Dinamiet/LifeCounter_PCB/LifeCounter.kicad_pcb

## KiCad design LifeCounter.kicad_pcb (2025-07-05)

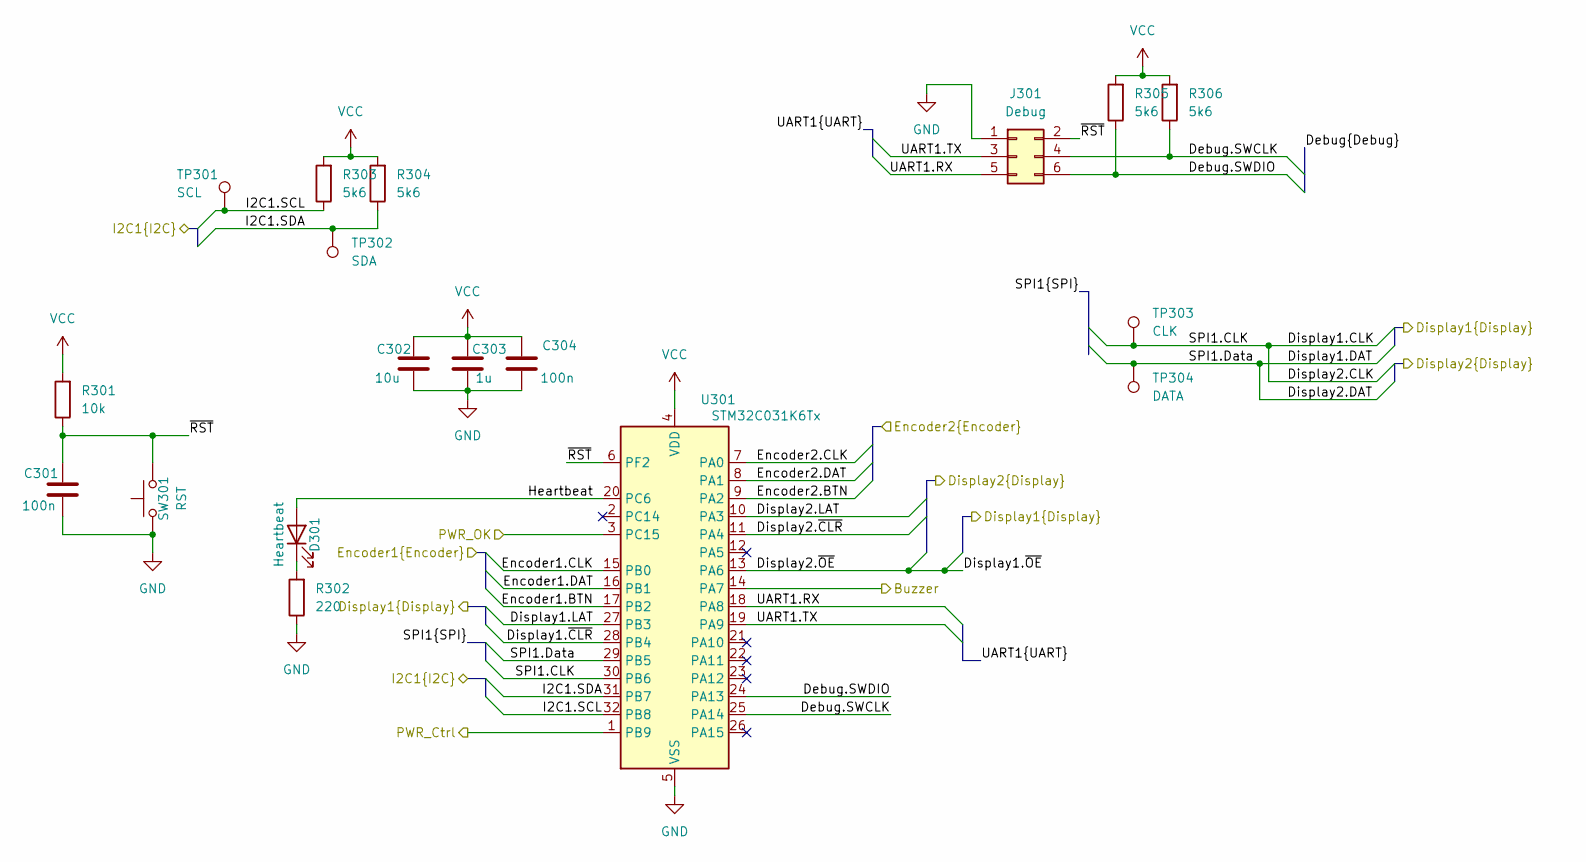
[picture p1: schematic controller.kicad_sch]

Parts:
C301, C304: 100n; C_1206_3216Metric_Pad1.33x1.80mm_HandSolder
C302: 10u; C_1206_3216Metric_Pad1.33x1.80mm_HandSolder
C303: 1u; C_0805_2012Metric_Pad1.18x1.45mm_HandSolder; LCSC C7393927
D301: Heartbeat; LED_1206_3216Metric_Pad1.42x1.75mm_HandSolder
J301: Debug; PinHeader_2x03_P2.54mm_Vertical_SMD
R301: 10k; R_1206_3216Metric_Pad1.30x1.75mm_HandSolder
R302: 220; R_1206_3216Metric_Pad1.30x1.75mm_HandSolder
R303, R304, R305, R306: 5k6; R_1206_3216Metric_Pad1.30x1.75mm_HandSolder
SW301: RST; SW_PUSH_6mm
TP301: SCL; TestPoint_Pad_D1.0mm
TP302: SDA; TestPoint_Pad_D1.0mm
TP303: CLK; TestPoint_Pad_D1.0mm
TP304: DATA; TestPoint_Pad_D1.0mm
U301: STM32C031K6Tx; LQFP-32_7x7mm_P0.8mm; LCSC C5456169

Connections:
/Buzzer/Buzz: U301.14 (PA7); also elsewhere on the board
/Controller/Debug.SWCLK: J301.4, R306.1, U301.25 (PA14)
/Controller/Debug.SWDIO: J301.6, R305.1, U301.24 (PA13)
/Controller/Encoder1.BTN: U301.17 (PB2); also elsewhere on the board
/Controller/Encoder1.CLK: U301.15 (PB0); also elsewhere on the board
/Controller/Encoder1.DAT: U301.16 (PB1); also elsewhere on the board
/Controller/Encoder2.BTN: U301.9 (PA2); also elsewhere on the board
/Controller/Encoder2.CLK: U301.7 (PA0); also elsewhere on the board
/Controller/Encoder2.DAT: U301.8 (PA1); also elsewhere on the board
/Controller/Heartbeat: D301.2 (A), U301.20 (PC6)
/Controller/I2C1.SCL: R303.1, TP301.1, U301.32 (PB8); also elsewhere on the board
/Controller/I2C1.SDA: R304.1, TP302.1, U301.31 (PB7); also elsewhere on the board
/Controller/PWR_Ctrl: U301.1 (PB9); also elsewhere on the board
/Controller/PWR_OK: U301.3 (PC15); also elsewhere on the board
/Controller/UART1.RX: J301.5, U301.18 (PA8)
/Controller/UART1.TX: J301.3, U301.19 (PA9)
/Controller/~RST: C301.1, J301.2, R301.1, SW301.2, U301.6 (PF2)
/Display1/CLK: TP303.1, U301.30 (PB6); also elsewhere on the board
/Display1/DAT: TP304.1, U301.29 (PB5); also elsewhere on the board
/Display1/LAT: U301.27 (PB3); also elsewhere on the board
/Display1/~CLR: U301.28 (PB4); also elsewhere on the board
/Display1/~OE: U301.13 (PA6); also elsewhere on the board
/Display2/LAT: U301.10 (PA3); also elsewhere on the board
/Display2/~CLR: U301.11 (PA4); also elsewhere on the board
GND: C301.2, C302.2, C303.2, C304.2, J301.1, R302.1, SW301.1, U301.5 (VSS); also elsewhere on the board
unnamed: D301.1 (K), R302.2
VCC: C302.1, C303.1, C304.1, R301.2, R303.2, R304.2, R305.2, R306.2, U301.4 (VDD); also elsewhere on the board

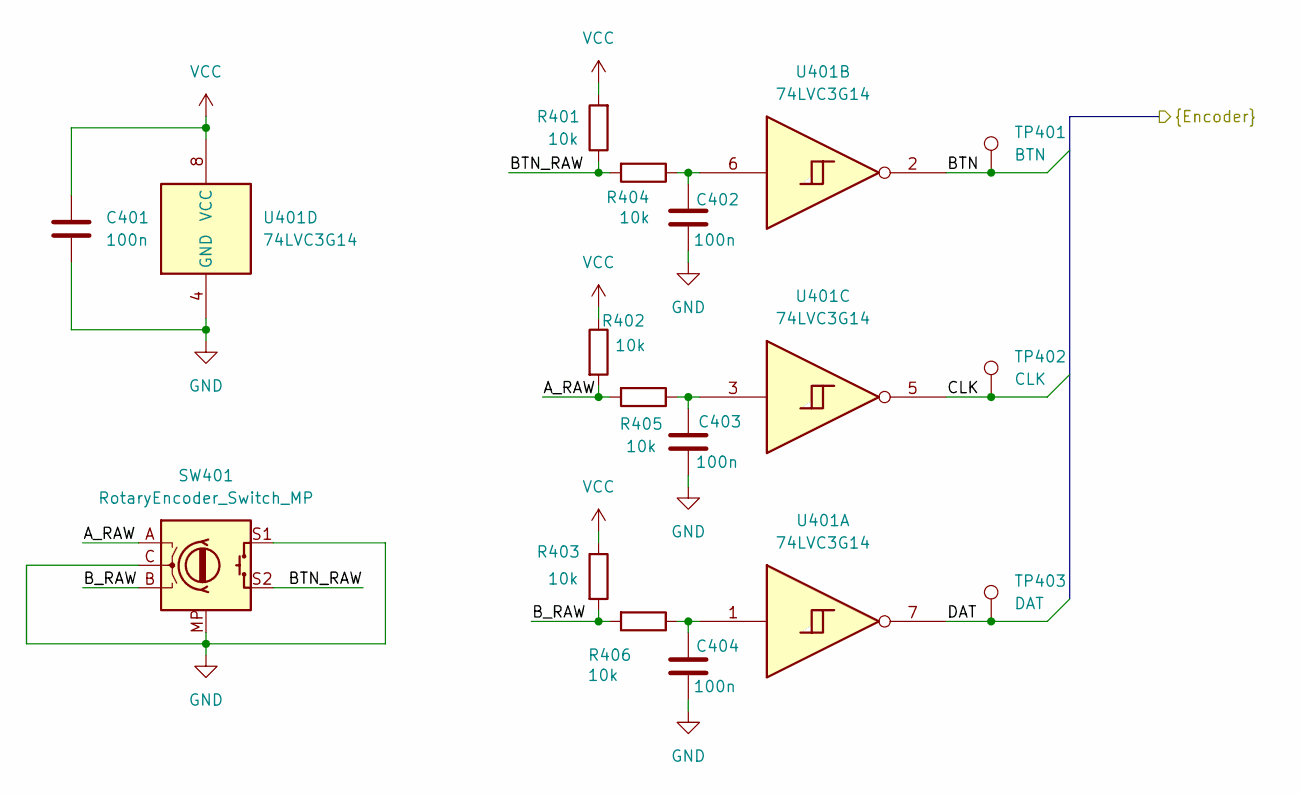
[picture p2: schematic encoder.kicad_sch]

Parts:
C401, C402, C403, C404: 100n; C_1206_3216Metric_Pad1.33x1.80mm_HandSolder
R401, R402, R403, R404, R405, R406: 10k; R_1206_3216Metric_Pad1.30x1.75mm_HandSolder
SW401: RotaryEncoder_Switch_MP; RotaryEncoder_Alps_EC12E-Switch_Vertical_H20mm; LCSC C470596
TP401: BTN; TestPoint_Pad_D1.0mm
TP402: CLK; TestPoint_Pad_D1.0mm
TP403: DAT; TestPoint_Pad_D1.0mm
U401: 74LVC3G14; VSSOP-8_2.3x2mm_P0.5mm; LCSC C98856

Connections:
/Controller/Encoder1.BTN: TP401.1, U401.2; also elsewhere on the board
/Controller/Encoder1.CLK: TP402.1, U401.5; also elsewhere on the board
/Controller/Encoder1.DAT: TP403.1, U401.7; also elsewhere on the board
/Encoder1/A_RAW: R402.2, R405.2, SW401.A
/Encoder1/BTN_RAW: R401.1, R404.2, SW401.S2
/Encoder1/B_RAW: R403.2, R406.2, SW401.B
GND: C401.2, C402.2, C403.2, C404.2, SW401.C, SW401.MP, SW401.S1, U401.4 (GND); also elsewhere on the board
unnamed: C402.1, R404.1, U401.6
unnamed: C403.1, R405.1, U401.3
unnamed: C404.1, R406.1, U401.1
VCC: C401.1, R401.2, R402.1, R403.1, U401.8 (VCC); also elsewhere on the board

Parts of its further copies:
C501, C502, C503, C504: 100n; C_1206_3216Metric_Pad1.33x1.80mm_HandSolder
R501, R502, R503, R504, R505, R506: 10k; R_1206_3216Metric_Pad1.30x1.75mm_HandSolder
SW501: RotaryEncoder_Switch_MP; RotaryEncoder_Alps_EC12E-Switch_Vertical_H20mm; LCSC C470596
TP501: BTN; TestPoint_Pad_D1.0mm
TP502: CLK; TestPoint_Pad_D1.0mm
TP503: DAT; TestPoint_Pad_D1.0mm
U501: 74LVC3G14; VSSOP-8_2.3x2mm_P0.5mm; LCSC C98856

Connections of its further copies:
/Controller/Encoder2.BTN: TP501.1, U501.2; also elsewhere on the board
/Controller/Encoder2.CLK: TP502.1, U501.5; also elsewhere on the board
/Controller/Encoder2.DAT: TP503.1, U501.7; also elsewhere on the board
/Encoder2/A_RAW: R502.2, R505.2, SW501.A
/Encoder2/BTN_RAW: R501.1, R504.2, SW501.S2
/Encoder2/B_RAW: R503.2, R506.2, SW501.B
GND: C501.2, C502.2, C503.2, C504.2, SW501.C, SW501.MP, SW501.S1, U501.4 (GND); also elsewhere on the board
unnamed: C502.1, R504.1, U501.6
unnamed: C503.1, R505.1, U501.3
unnamed: C504.1, R506.1, U501.1
VCC: C501.1, R501.2, R502.1, R503.1, U501.8 (VCC); also elsewhere on the board

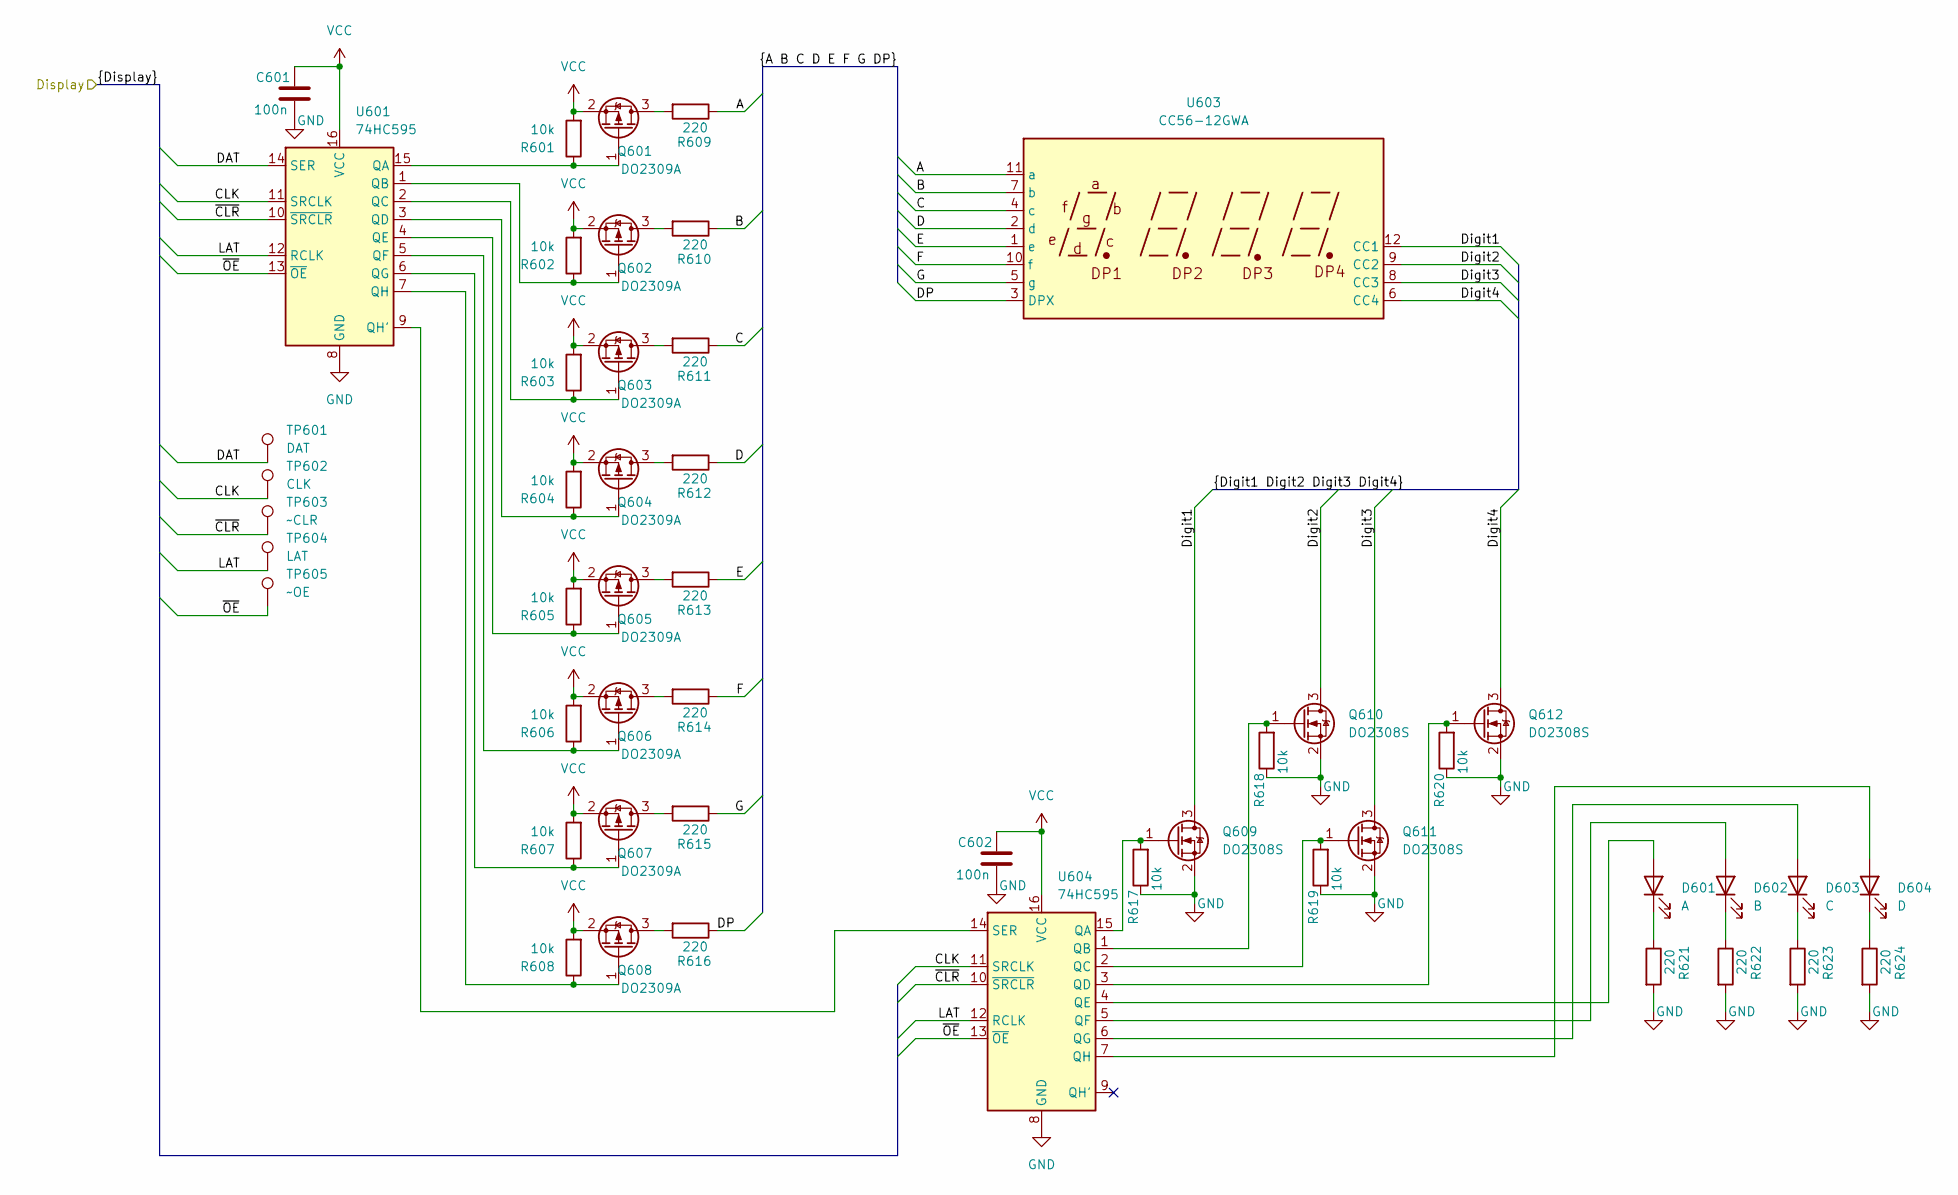
[picture p3: schematic display.kicad_sch]

Parts:
C601, C602: 100n; C_1206_3216Metric_Pad1.33x1.80mm_HandSolder
D601: A; LED_1206_3216Metric_Pad1.42x1.75mm_HandSolder
D602: B; LED_1206_3216Metric_Pad1.42x1.75mm_HandSolder
D603: C; LED_1206_3216Metric_Pad1.42x1.75mm_HandSolder
D604: D; LED_1206_3216Metric_Pad1.42x1.75mm_HandSolder
Q601, Q602, Q603, Q604, Q605, Q606, Q607, Q608: DO2309A; SOT-23_Handsoldering; LCSC C47018570
Q609, Q610, Q611, Q612: DO2308S; SOT-23_Handsoldering; LCSC C47018572
R601, R602, R603, R604, R605, R606, R607, R608, R617, R618, R619, R620: 10k; R_1206_3216Metric_Pad1.30x1.75mm_HandSolder
R609, R610, R611, R612, R613, R614, R615, R616, R621, R622, R623, R624: 220; R_1206_3216Metric_Pad1.30x1.75mm_HandSolder
TP601: DAT; TestPoint_Pad_D1.0mm
TP602: CLK; TestPoint_Pad_D1.0mm
TP603: ~CLR; TestPoint_Pad_D1.0mm
TP604: LAT; TestPoint_Pad_D1.0mm
TP605: ~OE; TestPoint_Pad_D1.0mm
U601, U604: 74HC595; SOIC-16_3.9x9.9mm_P1.27mm; LCSC C10092
U603: CC56-12GWA; LCSC C109200

Connections:
/Display1/A: R609.1, U603.11 (a)
/Display1/B: R610.1, U603.7 (b)
/Display1/C: R611.1, U603.4 (c)
/Display1/CLK: TP602.1, U601.11 (SRCLK), U604.11 (SRCLK); also elsewhere on the board
/Display1/D: R612.1, U603.2 (d)
/Display1/DAT: TP601.1, U601.14 (SER); also elsewhere on the board
/Display1/DP: R616.1, U603.3 (DPX)
/Display1/Digit1: Q609.3 (D), U603.12 (CC1)
/Display1/Digit2: Q610.3 (D), U603.9 (CC2)
/Display1/Digit3: Q611.3 (D), U603.8 (CC3)
/Display1/Digit4: Q612.3 (D), U603.6 (CC4)
/Display1/E: R613.1, U603.1 (e)
/Display1/F: R614.1, U603.10 (f)
/Display1/G: R615.1, U603.5 (g)
/Display1/LAT: TP604.1, U601.12 (RCLK), U604.12 (RCLK); also elsewhere on the board
/Display1/~CLR: TP603.1, U601.10 (~SRCLR), U604.10 (~SRCLR); also elsewhere on the board
/Display1/~OE: TP605.1, U601.13 (~OE), U604.13 (~OE); also elsewhere on the board
GND: C601.2, C602.2, Q609.2 (S), Q610.2 (S), Q611.2 (S), Q612.2 (S), R617.1, R618.1, R619.1, R620.1, R621.2, R622.2, R623.2, R624.2, U601.8 (GND), U604.8 (GND); also elsewhere on the board
unnamed: D601.2 (A), U604.4 (QE)
unnamed: D601.1 (K), R621.1
unnamed: D602.2 (A), U604.5 (QF)
unnamed: D602.1 (K), R622.1
unnamed: D603.2 (A), U604.6 (QG)
unnamed: D603.1 (K), R623.1
unnamed: D604.2 (A), U604.7 (QH)
unnamed: D604.1 (K), R624.1
unnamed: Q601.3 (D), R609.2
unnamed: Q601.1 (G), R601.1, U601.15 (QA)
unnamed: Q602.3 (D), R610.2
unnamed: Q602.1 (G), R602.1, U601.1 (QB)
unnamed: Q603.3 (D), R611.2
unnamed: Q603.1 (G), R603.1, U601.2 (QC)
unnamed: Q604.3 (D), R612.2
unnamed: Q604.1 (G), R604.1, U601.3 (QD)
unnamed: Q605.3 (D), R613.2
unnamed: Q605.1 (G), R605.1, U601.4 (QE)
unnamed: Q606.3 (D), R614.2
unnamed: Q606.1 (G), R606.1, U601.5 (QF)
unnamed: Q607.3 (D), R615.2
unnamed: Q607.1 (G), R607.1, U601.6 (QG)
unnamed: Q608.3 (D), R616.2
unnamed: Q608.1 (G), R608.1, U601.7 (QH)
unnamed: Q609.1 (G), R617.2, U604.15 (QA)
unnamed: Q610.1 (G), R618.2, U604.1 (QB)
unnamed: Q611.1 (G), R619.2, U604.2 (QC)
unnamed: Q612.1 (G), R620.2, U604.3 (QD)
unnamed: U601.9 (QH'), U604.14 (SER)
VCC: C601.1, C602.1, Q601.2 (S), Q602.2 (S), Q603.2 (S), Q604.2 (S), Q605.2 (S), Q606.2 (S), Q607.2 (S), Q608.2 (S), R601.2, R602.2, R603.2, R604.2, R605.2, R606.2, R607.2, R608.2, U601.16 (VCC), U604.16 (VCC); also elsewhere on the board

Parts of its further copies:
C701, C702: 100n; C_1206_3216Metric_Pad1.33x1.80mm_HandSolder
D701: A; LED_1206_3216Metric_Pad1.42x1.75mm_HandSolder
D702: B; LED_1206_3216Metric_Pad1.42x1.75mm_HandSolder
D703: C; LED_1206_3216Metric_Pad1.42x1.75mm_HandSolder
D704: D; LED_1206_3216Metric_Pad1.42x1.75mm_HandSolder
Q701, Q702, Q703, Q704, Q705, Q706, Q707, Q708: DO2309A; SOT-23_Handsoldering; LCSC C47018570
Q709, Q710, Q711, Q712: DO2308S; SOT-23_Handsoldering; LCSC C47018572
R701, R702, R703, R704, R705, R706, R707, R708, R717, R718, R719, R720: 10k; R_1206_3216Metric_Pad1.30x1.75mm_HandSolder
R709, R710, R711, R712, R713, R714, R715, R716, R721, R722, R723, R724: 220; R_1206_3216Metric_Pad1.30x1.75mm_HandSolder
TP701: DAT; TestPoint_Pad_D1.0mm
TP702: CLK; TestPoint_Pad_D1.0mm
TP703: ~CLR; TestPoint_Pad_D1.0mm
TP704: LAT; TestPoint_Pad_D1.0mm
TP705: ~OE; TestPoint_Pad_D1.0mm
U701, U704: 74HC595; SOIC-16_3.9x9.9mm_P1.27mm; LCSC C10092
U703: CC56-12GWA; LCSC C109200

Connections of its further copies:
/Display1/CLK: TP702.1, U701.11 (SRCLK), U704.11 (SRCLK); also elsewhere on the board
/Display1/DAT: TP701.1, U701.14 (SER); also elsewhere on the board
/Display1/~OE: TP705.1, U701.13 (~OE), U704.13 (~OE); also elsewhere on the board
/Display2/A: R709.1, U703.11 (a)
/Display2/B: R710.1, U703.7 (b)
/Display2/C: R711.1, U703.4 (c)
/Display2/D: R712.1, U703.2 (d)
/Display2/DP: R716.1, U703.3 (DPX)
/Display2/Digit1: Q709.3 (D), U703.12 (CC1)
/Display2/Digit2: Q710.3 (D), U703.9 (CC2)
/Display2/Digit3: Q711.3 (D), U703.8 (CC3)
/Display2/Digit4: Q712.3 (D), U703.6 (CC4)
/Display2/E: R713.1, U703.1 (e)
/Display2/F: R714.1, U703.10 (f)
/Display2/G: R715.1, U703.5 (g)
/Display2/LAT: TP704.1, U701.12 (RCLK), U704.12 (RCLK); also elsewhere on the board
/Display2/~CLR: TP703.1, U701.10 (~SRCLR), U704.10 (~SRCLR); also elsewhere on the board
GND: C701.2, C702.2, Q709.2 (S), Q710.2 (S), Q711.2 (S), Q712.2 (S), R717.1, R718.1, R719.1, R720.1, R721.2, R722.2, R723.2, R724.2, U701.8 (GND), U704.8 (GND); also elsewhere on the board
unnamed: D701.2 (A), U704.4 (QE)
unnamed: D701.1 (K), R721.1
unnamed: D702.2 (A), U704.5 (QF)
unnamed: D702.1 (K), R722.1
unnamed: D703.2 (A), U704.6 (QG)
unnamed: D703.1 (K), R723.1
unnamed: D704.2 (A), U704.7 (QH)
unnamed: D704.1 (K), R724.1
unnamed: Q701.3 (D), R709.2
unnamed: Q701.1 (G), R701.1, U701.15 (QA)
unnamed: Q702.3 (D), R710.2
unnamed: Q702.1 (G), R702.1, U701.1 (QB)
unnamed: Q703.3 (D), R711.2
unnamed: Q703.1 (G), R703.1, U701.2 (QC)
unnamed: Q704.3 (D), R712.2
unnamed: Q704.1 (G), R704.1, U701.3 (QD)
unnamed: Q705.3 (D), R713.2
unnamed: Q705.1 (G), R705.1, U701.4 (QE)
unnamed: Q706.3 (D), R714.2
unnamed: Q706.1 (G), R706.1, U701.5 (QF)
unnamed: Q707.3 (D), R715.2
unnamed: Q707.1 (G), R707.1, U701.6 (QG)
unnamed: Q708.3 (D), R716.2
unnamed: Q708.1 (G), R708.1, U701.7 (QH)
unnamed: Q709.1 (G), R717.2, U704.15 (QA)
unnamed: Q710.1 (G), R718.2, U704.1 (QB)
unnamed: Q711.1 (G), R719.2, U704.2 (QC)
unnamed: Q712.1 (G), R720.2, U704.3 (QD)
unnamed: U701.9 (QH'), U704.14 (SER)
VCC: C701.1, C702.1, Q701.2 (S), Q702.2 (S), Q703.2 (S), Q704.2 (S), Q705.2 (S), Q706.2 (S), Q707.2 (S), Q708.2 (S), R701.2, R702.2, R703.2, R704.2, R705.2, R706.2, R707.2, R708.2, U701.16 (VCC), U704.16 (VCC); also elsewhere on the board

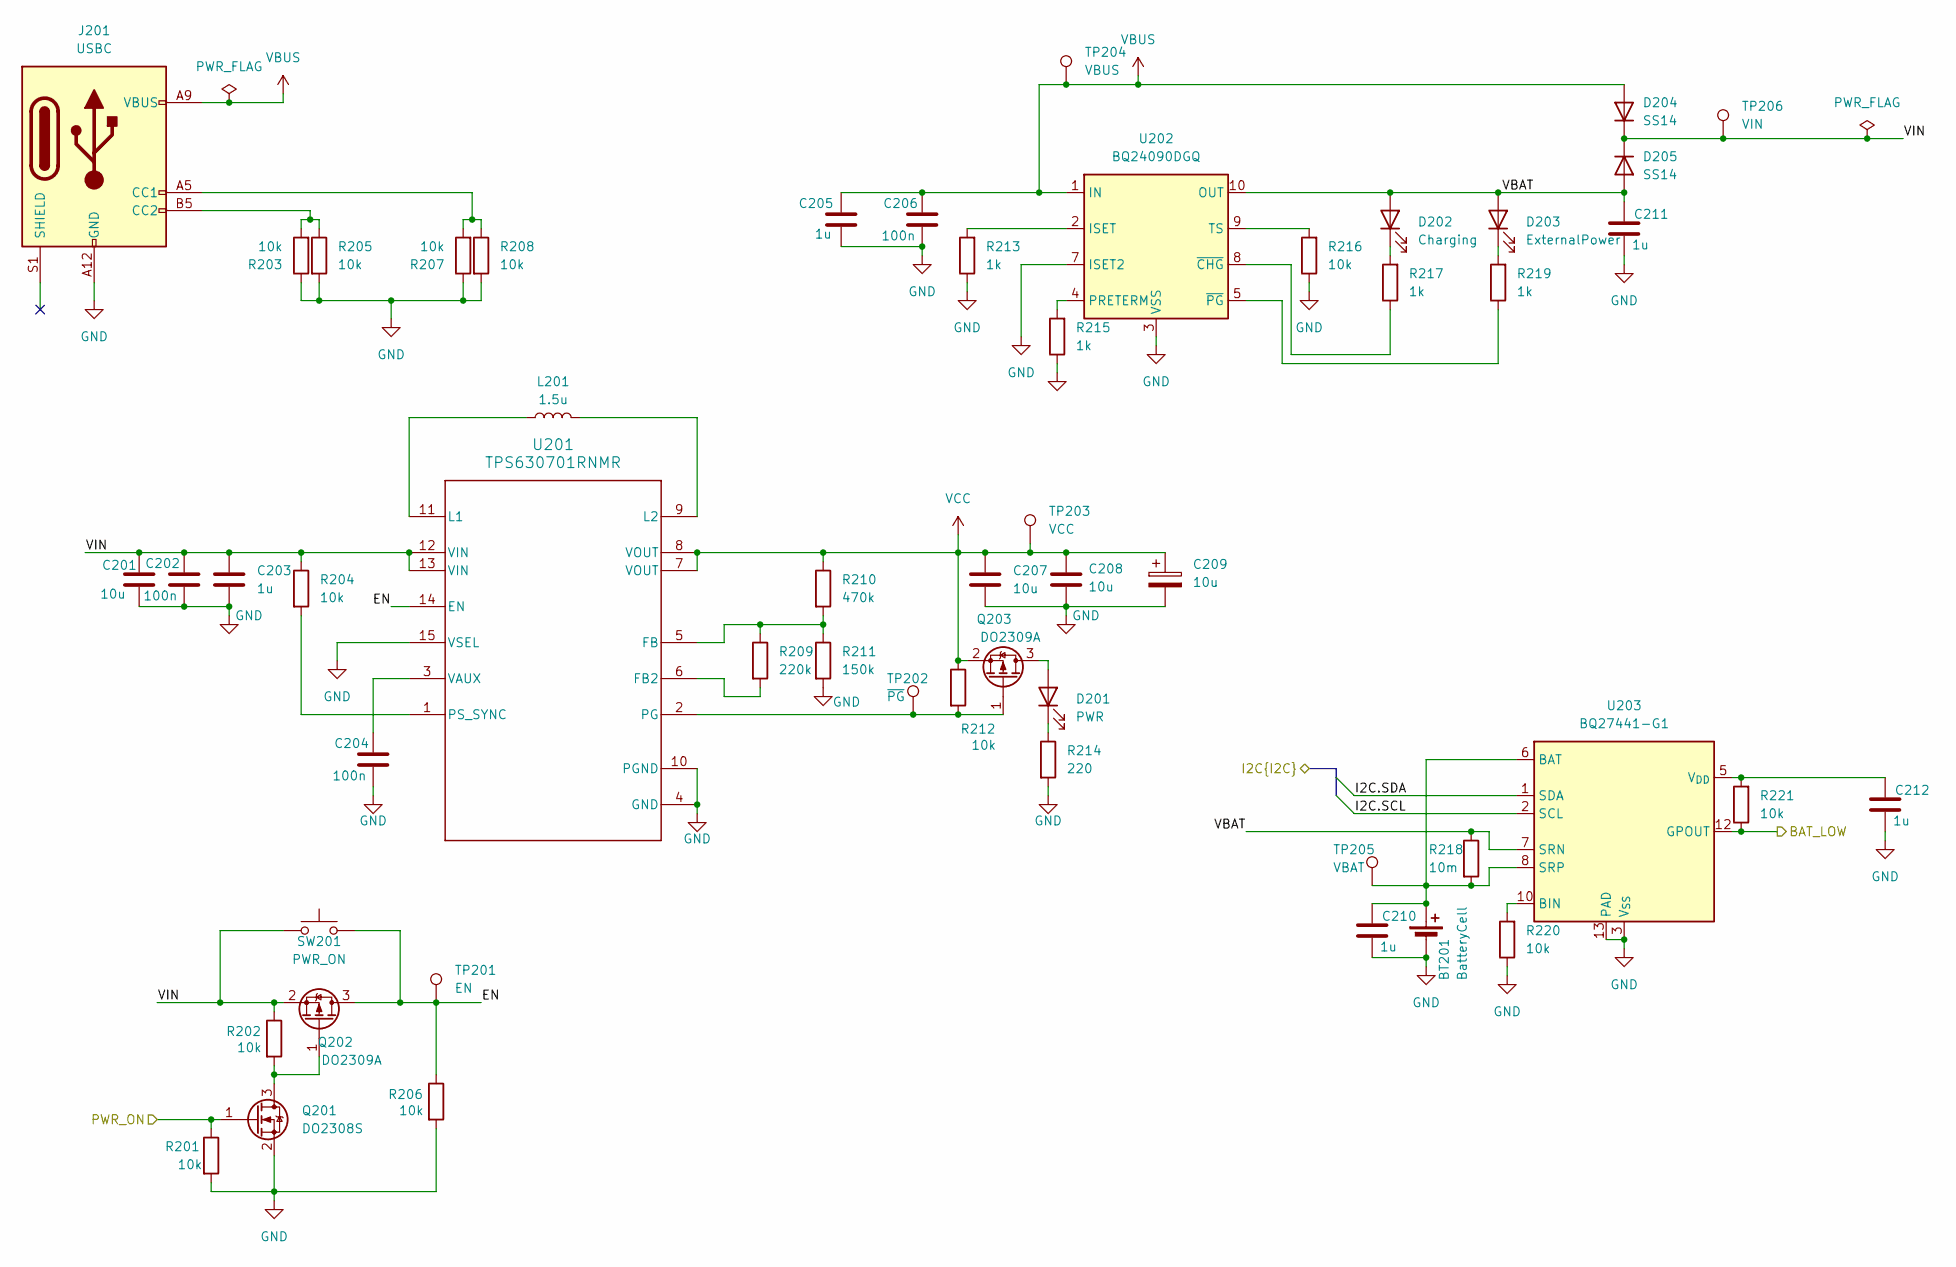
[picture p4: schematic power.kicad_sch]

Parts:
BT201: BatteryCell; BatteryHolder_MPD_BH-18650-PC; LCSC C5290175
C201, C207, C208: 10u; C_1206_3216Metric_Pad1.33x1.80mm_HandSolder
C202, C204, C206: 100n; C_1206_3216Metric_Pad1.33x1.80mm_HandSolder
C203, C205, C210, C211, C212: 1u; C_0805_2012Metric_Pad1.18x1.45mm_HandSolder; LCSC C7393927
C209: 10u; CP_EIA-7343-31_Kemet-D_HandSolder
D201: PWR; LED_1206_3216Metric_Pad1.42x1.75mm_HandSolder
D202: Charging; LED_1206_3216Metric_Pad1.42x1.75mm_HandSolder
D203: ExternalPower; LED_1206_3216Metric_Pad1.42x1.75mm_HandSolder
D204, D205: SS14; D_SMA_Handsoldering; LCSC C2986110
J201: USBC; USB_C_Receptacle_GCT_USB4125-xx-x_6P_TopMnt_Horizontal; LCSC C42400234
L201: 1.5u; L_Cenker_CKCS4020; LCSC C5442006
Q201: DO2308S; SOT-23_Handsoldering; LCSC C47018572
Q202, Q203: DO2309A; SOT-23_Handsoldering; LCSC C47018570
R201, R202, R203, R204, R205, R206, R207, R208, R212, R216, R220, R221: 10k; R_1206_3216Metric_Pad1.30x1.75mm_HandSolder
R209: 220k; R_0805_2012Metric_Pad1.20x1.40mm_HandSolder; LCSC C5140137
R210: 470k; R_0805_2012Metric_Pad1.20x1.40mm_HandSolder; LCSC C3016836
R211: 150k; R_0805_2012Metric_Pad1.20x1.40mm_HandSolder; LCSC C365243
R213, R215, R217, R219: 1k; R_1206_3216Metric_Pad1.30x1.75mm_HandSolder
R214: 220; R_1206_3216Metric_Pad1.30x1.75mm_HandSolder
R218: 10m; R_0805_2012Metric_Pad1.20x1.40mm_HandSolder; LCSC C2961480
SW201: PWR_ON; SW_PUSH_6mm
TP201: EN; TestPoint_Pad_D1.0mm
TP202: ~{PG}; TestPoint_Pad_D1.0mm
TP203: VCC; TestPoint_Pad_D1.0mm
TP204: VBUS; TestPoint_Pad_D1.0mm
TP205: VBAT; TestPoint_Pad_D1.0mm
TP206: VIN; TestPoint_Pad_D1.0mm
U201: TPS630701RNMR; TPS63070; LCSC C109322
U202: BQ24090DGQ; HVSSOP-10-1EP_3x3mm_P0.5mm_EP1.57x1.88mm; LCSC C43306
U203: BQ27441-G1; Texas_S-PDSO-N12; LCSC C2864880

Connections:
/Controller/I2C1.SCL: U203.2 (SCL); also elsewhere on the board
/Controller/I2C1.SDA: U203.1 (SDA); also elsewhere on the board
/Controller/PWR_Ctrl: Q201.1 (G), R201.1; also elsewhere on the board
/Controller/PWR_OK: R221.1, U203.12 (GPOUT); also elsewhere on the board
/Power/EN: Q202.3 (D), R206.1, SW201.2, TP201.1, U201.14 (EN)
/Power/VBAT: C211.1, D202.2 (A), D203.2 (A), D205.2 (A), R218.1, U202.10 (OUT), U203.7 (SRN)
/Power/VIN: C201.1, C202.1, C203.1, D204.1 (K), D205.1 (K), Q202.2 (S), R202.1, R204.1, SW201.1, TP206.1, U201.12 (VIN), U201.13 (VIN)
GND: BT201.2 (-), C201.2, C202.2, C203.2, C204.2, C205.2, C206.2, C207.2, C208.2, C209.2, C210.2, C211.2, C212.2, J201.A12 (GND), J201.B12 (GND), Q201.2 (S), R201.2, R203.1, R205.2, R206.2, R207.1, R208.2, R211.2, R213.1, R214.2, R215.1, R216.1, R220.1, U201.4 (GND), U201.10 (PGND), U201.15 (VSEL), U202.3 (VSS), U202.7 (ISET2), U202.11 (VSS), U203.3 (V_{SS}), U203.13 (PAD); also elsewhere on the board
unnamed: BT201.1 (+), C210.1, R218.2, TP205.1, U203.6 (BAT), U203.8 (SRP)
unnamed: D201.2 (A), Q203.3 (D)
unnamed: D201.1 (K), R214.1
unnamed: D202.1 (K), R217.2
unnamed: D203.1 (K), R219.2
unnamed: J201.A5 (CC1), R207.2, R208.1
unnamed: J201.B5 (CC2), R203.2, R205.1
unnamed: Q201.3 (D), Q202.1 (G), R202.2
unnamed: Q203.1 (G), R212.2, TP202.1, U201.2 (PG)
unnamed: R209.2, U201.6 (FB2)
unnamed: R209.1, R210.2, R211.1, U201.5 (FB)
unnamed: L201.1, U201.11 (L1)
unnamed: L201.2, U201.9 (L2)
unnamed: R204.2, U201.1 (PS_SYNC)
unnamed: C204.1, U201.3 (VAUX)
unnamed: R213.2, U202.2 (ISET)
unnamed: R215.2, U202.4 (PRETERM)
unnamed: R216.2, U202.9 (TS)
unnamed: R217.1, U202.8 (~CHG)
unnamed: R219.1, U202.5 (~PG)
unnamed: R220.2, U203.10 (BIN)
unnamed: C212.1, R221.2, U203.5 (V_{DD})
VBUS: C205.1, C206.1, D204.2 (A), J201.A9 (VBUS), J201.B9 (VBUS), TP204.1, U202.1 (IN)
VCC: C207.1, C208.1, C209.1, Q203.2 (S), R210.1, R212.1, TP203.1, U201.7 (VOUT), U201.8 (VOUT); also elsewhere on the board

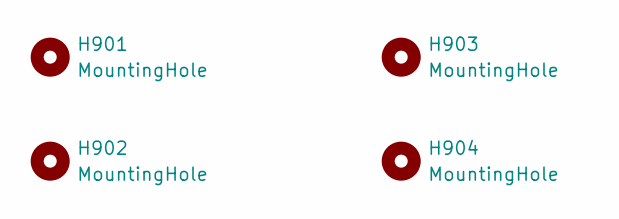
[picture p5: schematic mounting.kicad_sch]

Parts:
H901, H902, H903, H904: MountingHole; MountingHole_2mm

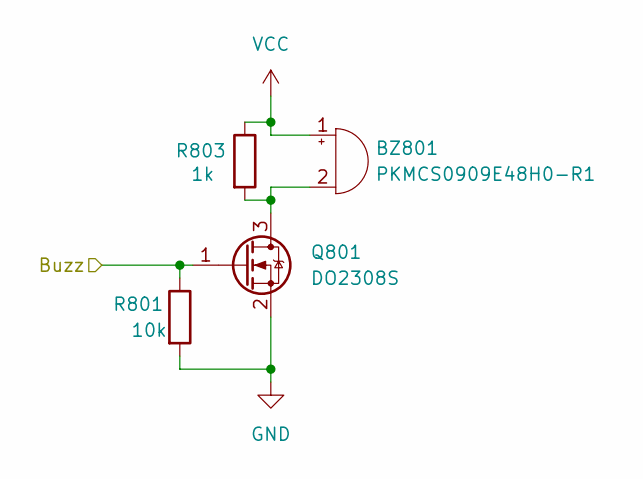
[picture p6: schematic buzzer.kicad_sch]

Parts:
BZ801: PKMCS0909E48H0-R1; Buzzer_12x9.5RM7.6
Q801: DO2308S; SOT-23_Handsoldering; LCSC C47018572
R801: 10k; R_1206_3216Metric_Pad1.30x1.75mm_HandSolder
R803: 1k; R_1206_3216Metric_Pad1.30x1.75mm_HandSolder

Connections:
/Buzzer/Buzz: Q801.1 (G), R801.1; also elsewhere on the board
GND: Q801.2 (S), R801.2; also elsewhere on the board
unnamed: BZ801.2 (-), Q801.3 (D), R803.2
VCC: BZ801.1 (+), R803.1; also elsewhere on the board

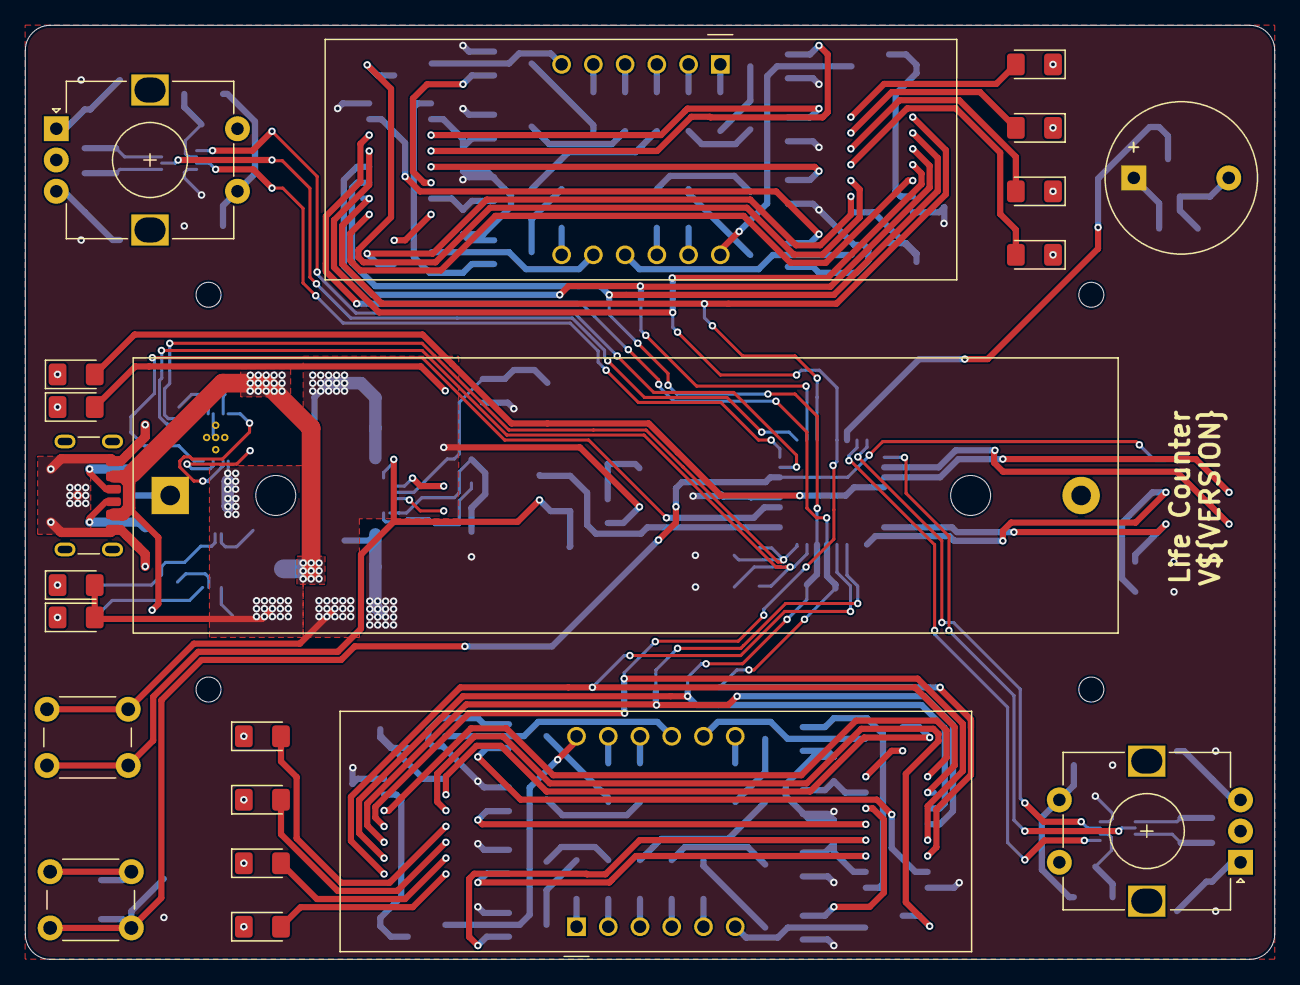
[picture p7: board LifeCounter.kicad_pcb from above]

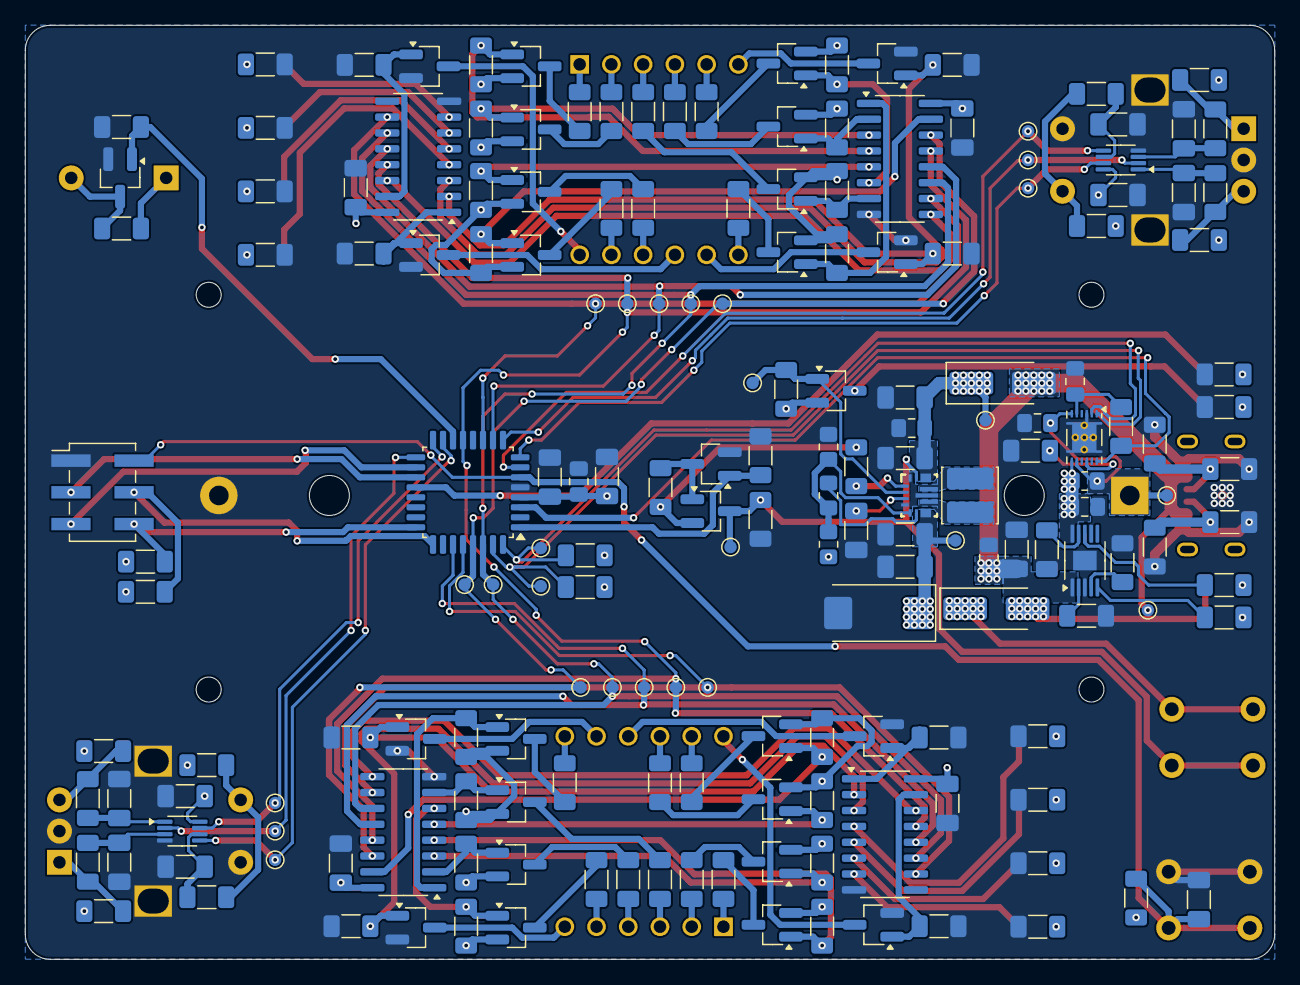
[picture p8: board LifeCounter.kicad_pcb from below]

Board: 2 copper layers, 100.0 x 74.8 mm, 210 parts (185 on the bottom side), 148 nets.
