Dinamiet/LifeCounter_PCB/(commit log)

2024-12-23 Project creation
    [LifeCounter.kicad_pcb, LifeCounter.kicad_sch]
2024-12-23 Ignore extra KiCad files
2024-12-23 Display and Status circuits added
    [LifeCounter.kicad_sch]
2024-12-24 Add encoders
    [LifeCounter.kicad_sch]
2024-12-24 Add buzzer
    [LifeCounter.kicad_sch]
2024-12-24 Split schematic into multiple sheets
    [LifeCounter.kicad_sch, controller.kicad_sch, power.kicad_sch, user_interactions.kicad_sch]
2024-12-25 Power layout
    [LifeCounter.kicad_sch, power.kicad_sch]
2024-12-25 Constant current sink status driver
    [io.kicad_sch]
2024-12-25 Controller selection
    [LifeCounter.kicad_sch, controller.kicad_sch, io.kicad_sch, power.kicad_sch]
2025-01-10 Controller wiring and schematic semantics
    [LifeCounter.kicad_sch, buzzer.kicad_sch, controller.kicad_sch, display.kicad_sch, encoder.kicad_sch, io.kicad_sch, power.kicad_sch, status.kicad_sch]
2025-01-10 Add mounting holes
    [LifeCounter.kicad_sch, mounting.kicad_sch]
2025-01-10 Component hookup
    [LifeCounter.kicad_sch, display.kicad_sch]
2025-01-10 Decoupling caps for ICs
    [LifeCounter.kicad_sch, display.kicad_sch, power.kicad_sch]
2025-01-10 LED descriptions - Status LEDs could use some more work
    [controller.kicad_sch, power.kicad_sch, status.kicad_sch]
2025-01-10 Initial component placement
    [LifeCounter.kicad_pcb, buzzer.kicad_sch, controller.kicad_sch, display.kicad_sch, encoder.kicad_sch, mounting.kicad_sch, power.kicad_sch, status.kicad_sch]
2025-01-18 Initial layout
    [LifeCounter.kicad_pcb, buzzer.kicad_sch, controller.kicad_sch, display.kicad_sch, encoder.kicad_sch, power.kicad_sch, status.kicad_sch]
2025-02-15 Switch transistors to FETs
    [buzzer.kicad_sch, controller.kicad_sch, display.kicad_sch, encoder.kicad_sch, power.kicad_sch, status.kicad_sch]
2025-02-21 Constant current sink to status LEDs and rewiring controller
    [LifeCounter.kicad_sch, controller.kicad_sch, display.kicad_sch, status.kicad_sch]
2025-04-04 Power control using p-channel for switching
    [power.kicad_sch]
2025-04-04 KiCAD version update
    [LifeCounter.kicad_sch, buzzer.kicad_sch, controller.kicad_sch, display.kicad_sch, encoder.kicad_sch, mounting.kicad_sch, status.kicad_sch]
2025-04-05 Assign component values to display passives
    [display.kicad_sch]
2025-04-05 Status component value assignment
    [status.kicad_sch]
2025-04-05 Encoder component values
    [encoder.kicad_sch]
2025-04-05 Power component value assignment
    [power.kicad_sch]
2025-04-05 Buzzer component value assignment
    [buzzer.kicad_sch]
2025-04-05 Controller component value assignment
    [controller.kicad_sch]
2025-04-06 Decoupling capacitor change from 10u to 1u
    [display.kicad_sch, power.kicad_sch, status.kicad_sch]
2025-04-06 Resolve ERC warnings
    [LifeCounter.kicad_sch, buzzer.kicad_sch, controller.kicad_sch, display.kicad_sch, encoder.kicad_sch, mounting.kicad_sch, power.kicad_sch, status.kicad_sch]
2025-04-12 5k1 USB resistors
2025-04-12 Add Testpoints
    [controller.kicad_sch, display.kicad_sch, encoder.kicad_sch, power.kicad_sch, status.kicad_sch]
2025-04-12 Footprint selection
    [buzzer.kicad_sch, controller.kicad_sch, display.kicad_sch, encoder.kicad_sch, mounting.kicad_sch, power.kicad_sch, status.kicad_sch]
2025-04-21 Using Schmitt trigger for encoder debouncing
    [encoder.kicad_sch]
2025-04-22 Add decoupling capacitor to Schmitt trigger
    [encoder.kicad_sch]
2025-04-22 Clean layout
    [LifeCounter.kicad_pcb]
2025-04-23 Polarized Tantalum capacitor symbol
    [power.kicad_sch]
2025-04-23 Using larger footprint for Status LED driver
    [status.kicad_sch]
2025-04-23 Encoder bus names change
    [controller.kicad_sch]
2025-04-23 Split encoder raw and filtered signal names
    [encoder.kicad_sch]
2025-04-23 USB 10k//10k CC resistors
    [power.kicad_sch]
2025-04-23 Initial component grouping and placement
    [LifeCounter.kicad_pcb]
2025-04-25 Update component footprint selection
    [buzzer.kicad_sch, power.kicad_sch]
2025-04-25 Organise subcircuit layouts
    [LifeCounter.kicad_pcb]
2025-04-26 Fix encoder debounce
    [LifeCounter.kicad_pcb, encoder.kicad_sch]
2025-04-26 Initial board layout
    [LifeCounter.kicad_pcb]
2025-04-27 Update track constraints
2025-04-27 Started routing component blocks
    [LifeCounter.kicad_pcb]
2025-04-28 Fix controller encoder bus names
    [controller.kicad_sch]
2025-04-28 Routing player status LEDs and display
    [LifeCounter.kicad_pcb]
2025-04-28 Center led driver
    [LifeCounter.kicad_pcb]
2025-04-28 Power routed
    [LifeCounter.kicad_pcb]
2025-04-28 Fix some DRC errors, silkscreen overlaps and cutoffs still outstanding
    [LifeCounter.kicad_pcb]
2025-05-12 Use new regulator
    [power.kicad_sch]
2025-05-12 Buzzer using high switch
    [buzzer.kicad_sch]
2025-05-12 Selected buzzer components
    [buzzer.kicad_sch]
2025-05-12 Library rename and add buck-boost regulator
2025-05-12 Using buck-boost regulator
    [power.kicad_sch]
2025-05-12 Remove display and status for redo
    [LifeCounter.kicad_sch, display.kicad_sch, status.kicad_sch]
2025-05-12 Shift register display and status
    [display.kicad_sch]
2025-05-13 Second display
    [display.kicad_sch]
2025-05-13 Reroute CPU for new display driving
    [controller.kicad_sch]
2025-05-13 Connect displays to controller
    [LifeCounter.kicad_sch]
2025-05-16 Page reordering
    [LifeCounter.kicad_sch, display.kicad_sch, power.kicad_sch]
2025-06-10 Assign component LCSC part numbers
    [buzzer.kicad_sch, controller.kicad_sch, display.kicad_sch, encoder.kicad_sch, power.kicad_sch]
2025-06-11 New layout with updated constraints
    [LifeCounter.kicad_pcb]
2025-06-14 Simplify some schematics to reduce BOM
    [buzzer.kicad_sch, display.kicad_sch, power.kicad_sch]
2025-06-14 Layout of display and power
    [LifeCounter.kicad_pcb]
2025-06-15 Subcircuits routed
    [LifeCounter.kicad_pcb, display.kicad_sch]
2025-07-01 Swapped pins for user elements to make routing easier
    [controller.kicad_sch]
2025-07-01 Fix unconnected pin
    [display.kicad_sch]
2025-07-01 Everything routed :)
    [LifeCounter.kicad_pcb]
2025-07-01 Move silkscreen text to comments layer
    [LifeCounter.kicad_pcb]
2025-07-03 Resolve DRC issues
    [LifeCounter.kicad_pcb]
2025-07-04 Rounded PCB corners
    [LifeCounter.kicad_pcb]
2025-07-04 Add version to silkscreen
    [LifeCounter.kicad_pcb]
2025-07-04 Plot settings updated
    [LifeCounter.kicad_pcb]
2025-07-05 Update BOM options for export
    [buzzer.kicad_sch, controller.kicad_sch, display.kicad_sch, encoder.kicad_sch, power.kicad_sch]
